xyvren/SAUVC_2027_TERU_UBB/docs/assets/preview_split_ui.png

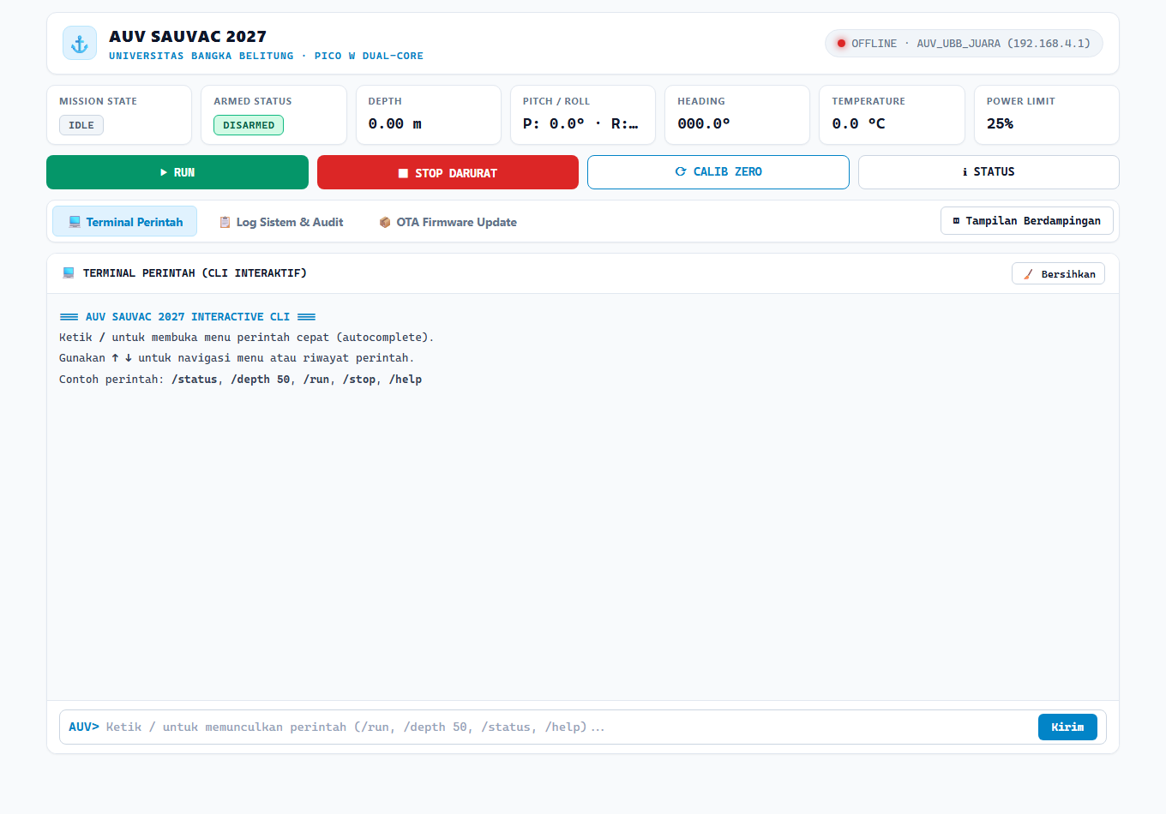
docs/assets/preview_split_ui.png
