xyvren/SAUVC_2027_TERU_UBB/docs/assets/preview_web_ui.png

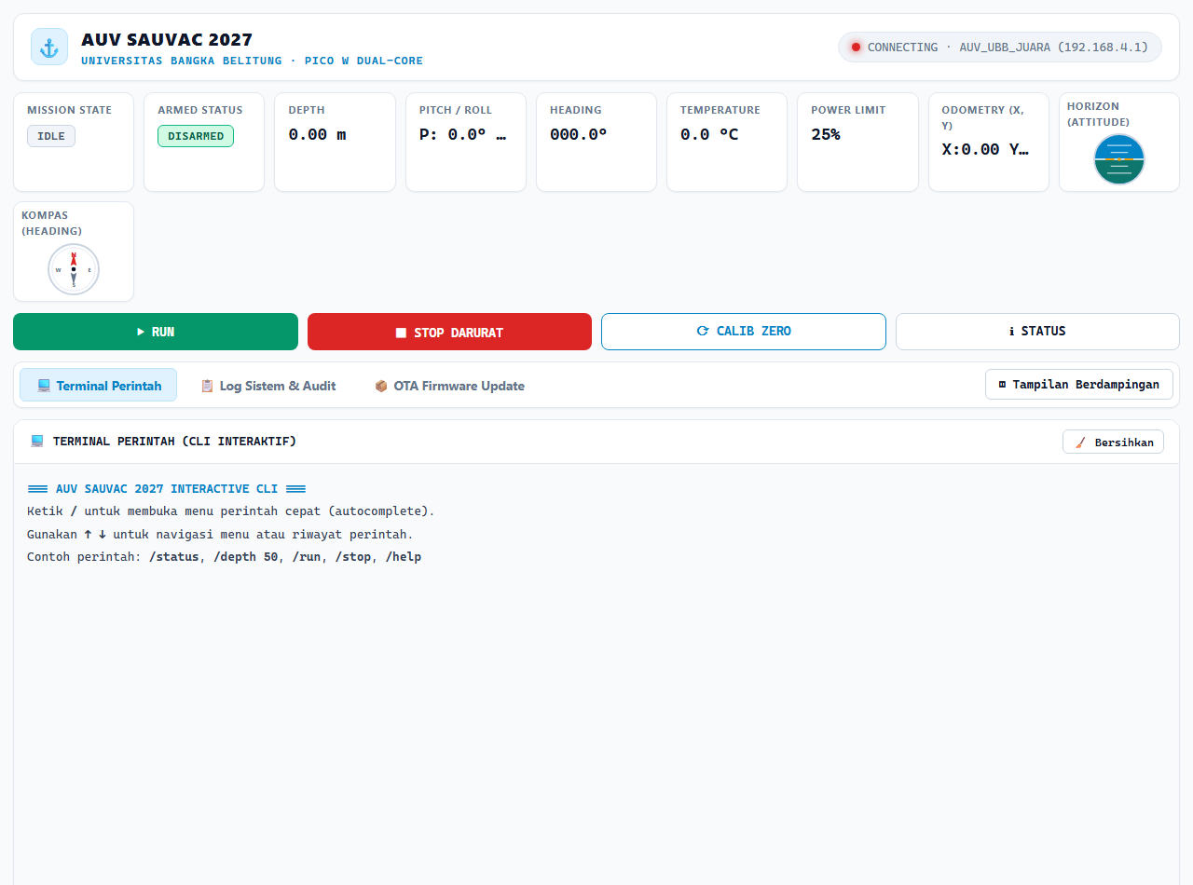
docs/assets/preview_web_ui.png
