xyvren/SAUVC_2027_TERU_UBB/Dsains 3D & Gambar Dsains/Dsains SAUVC.stl

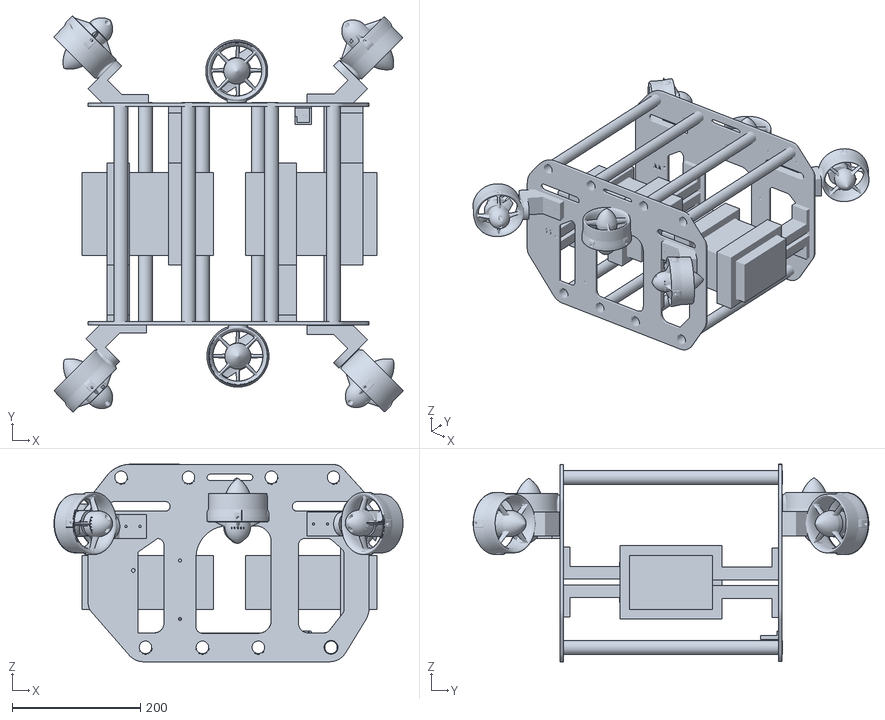
[picture p19: CAD file, 2026-11-10]
Dsains 3D & Gambar Dsains/Dsains SAUVC.stl
544.1 x 616.9 x 308.2
