xyvren/SAUVC_2027_TERU_UBB/(commit log)

2026-11-10 AUV SAUVAC Firmware v1.0: Autonomous 6-Thruster Control, Web Terminal, Animated Docs & Release Binaries
    [Dsains SAUVC.stl]
2026-11-10 Fix: Ensure single motor test continuous pulse streaming without early neutralization
    [main.cpp]
2026-11-10 fix: resolve negative percent motor test pulse calculation and smart autorun cancellation
    [cli_engine.cpp, main.cpp]
2026-11-10 feat: add 'tes' alias, support 'set thruster', and update T5 CCW / T6 CW orientations
2026-11-10 feat: apply acoustic-calibrated thruster parameters (T5 reverse=1, per-thruster rev_boost) with EEPROM v8 migration
    [main.cpp, rov_config.h]
2026-11-10 feat: implement online RL-PID adaptive gain tuning engine with safety constraints
2026-11-11 fix: invert percentage motor test pulse with settings.reverse and set T5/T6 default reverse to 1
    [main.cpp, rov_config.h]
